JoshuaBlack0704/nerfturret/cad/Assembled Turret.png

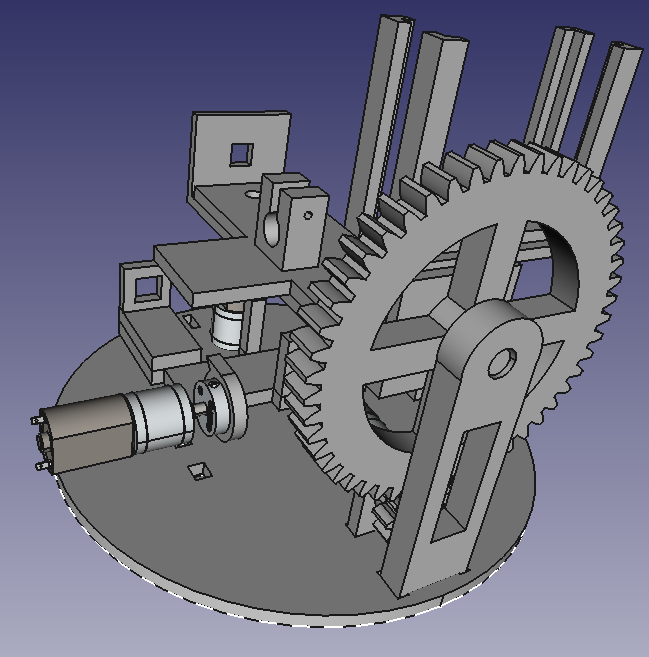
cad/Assembled Turret.png
