JoshuaBlack0704/nerfturret/cad/Base Plate Assembly.png

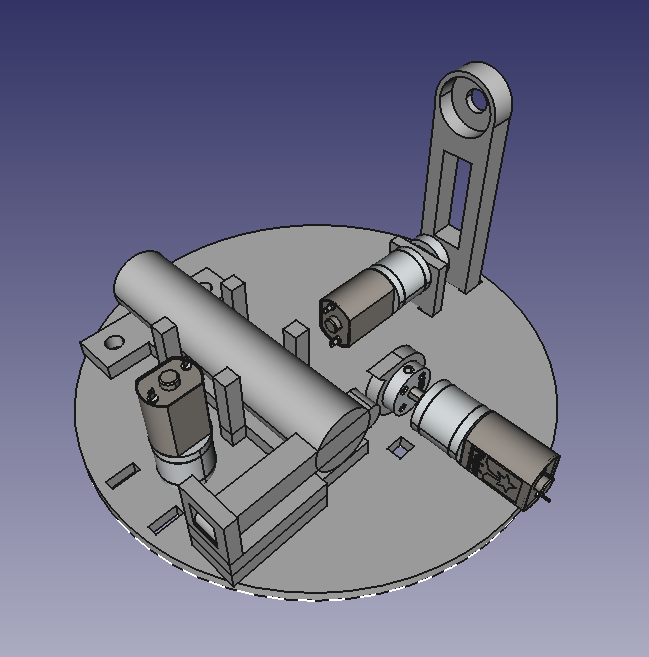
cad/Base Plate Assembly.png
