JoshuaBlack0704/nerfturret/Final Presentation Joshua Black.pdf

# Nerf Turret Project

### Produced Solo By

# Joshua Black

### Mechanical Engineering Senior

2

## Project Outline

### 1. Goals 2. Constraints 3. Mechanical Design 4. Electrical Design

### 5. Software Design

### 6. Results

0 3

## Goals

Pan-Tilt turret connectable to household network technologies 1 such as Wi-Fi.

4

Remotely controllable from any laptop. Propel Nerf darts.
Could be used to defer porch thieves.

## Constraits

- Must connect to WPA2 encrypted network. (Smart phone hot spot)
- Main structure must be 3-D printable.
- Use pressurized gas. (Potential for pepper spray)
- 5V power supply.
- Must be controlled through network clients.

2

5

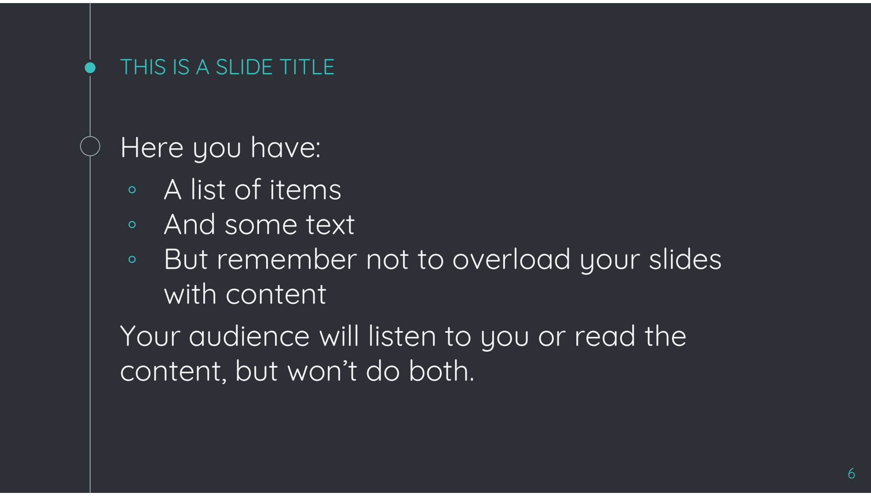
[picture p3: figure]
THIS IS A SLIDE TITLE; Here you have: ◦ A list of items ◦ And some text; with content; content, but won’t do both.

## - But remember not to overload your slides

## Your audience will listen to you or read the

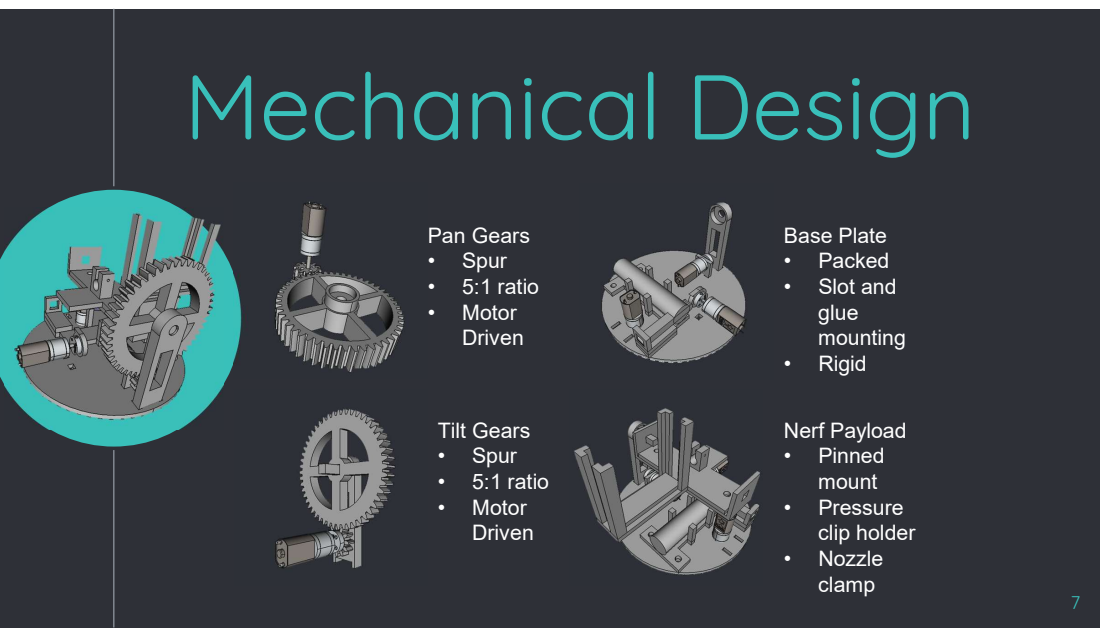
[picture p4: page 7]
Pan Gears • Spur • 5:1 ratio • Motor Driven; Tilt Gears • Spur • 5:1 ratio • Motor Driven; Base Plate • Packed • Slot and glue mounting • Rigid; Nerf Payload • Pinned mount • Pressure clip holder • Nozzle clamp

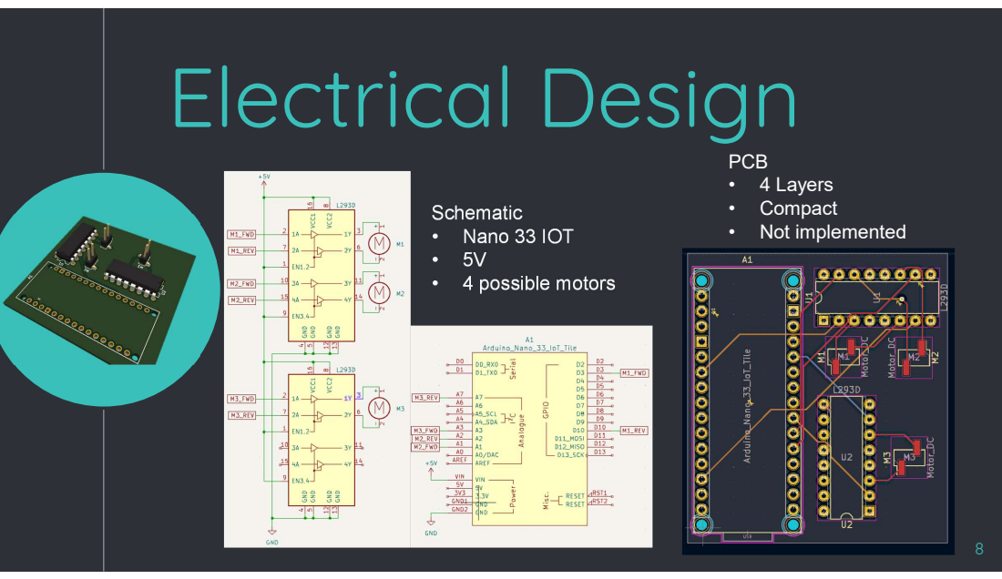
[picture p5: page 8]
Schematic • Nano 33 IOT • 5V • 4 possible motors; PCB • 4 Layers • Compact • Not implemented

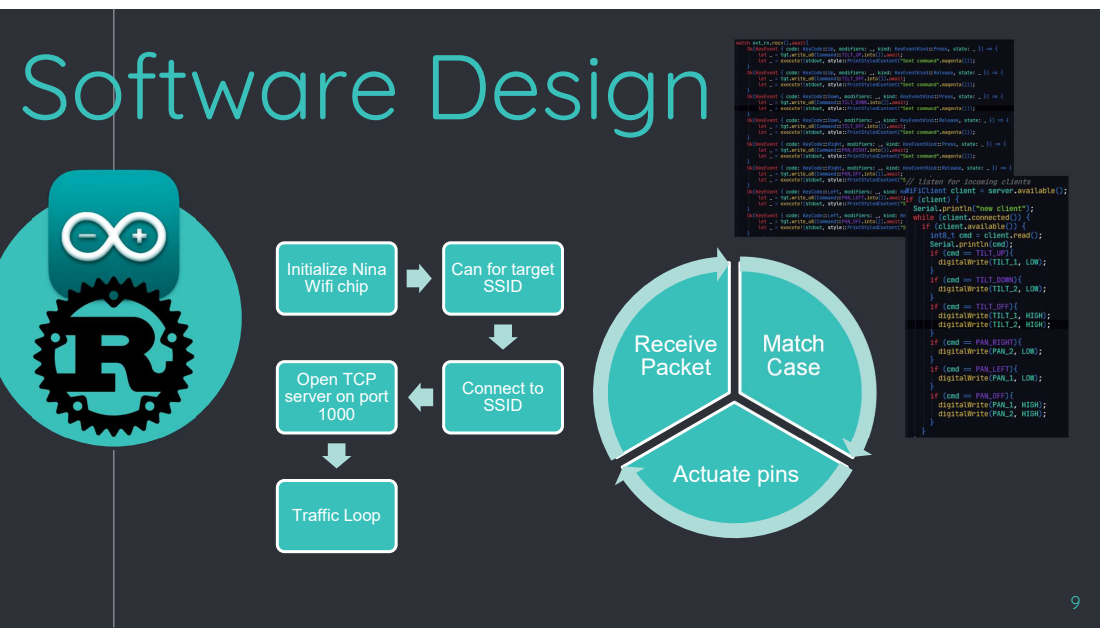
[picture p6: page 9]
Initialize Nina Wifi chip; Connect to SSID; Traffic Loop; Match Case; Actuate pins; Receive Packet

Can for target
SSID

Open TCP
server on port

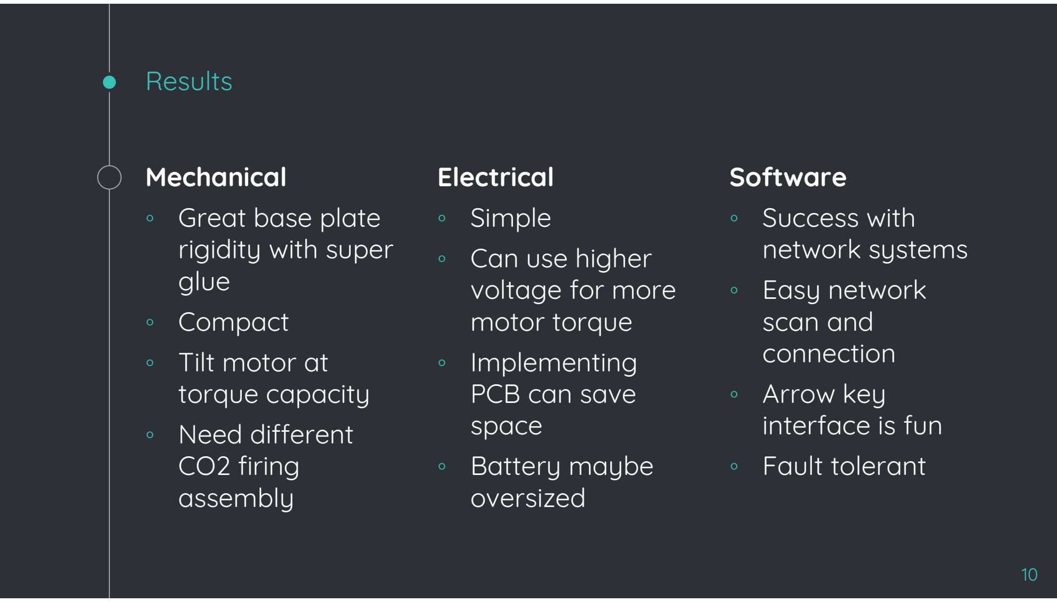
[picture p7: figure]
Results; Mechanical ◦ Great base plate rigidity with super glue ◦ Compact ◦ Tilt motor at torque capacity ◦ Need different CO2 firing assembly; Electrical ◦ Simple ◦ Can use higher voltage for more motor torque ◦ Implementing PCB can save space ◦ Battery maybe oversized; Software ◦ Success with network systems ◦ Easy network scan and connection ◦ Arrow key interface is fun ◦ Fault tolerant

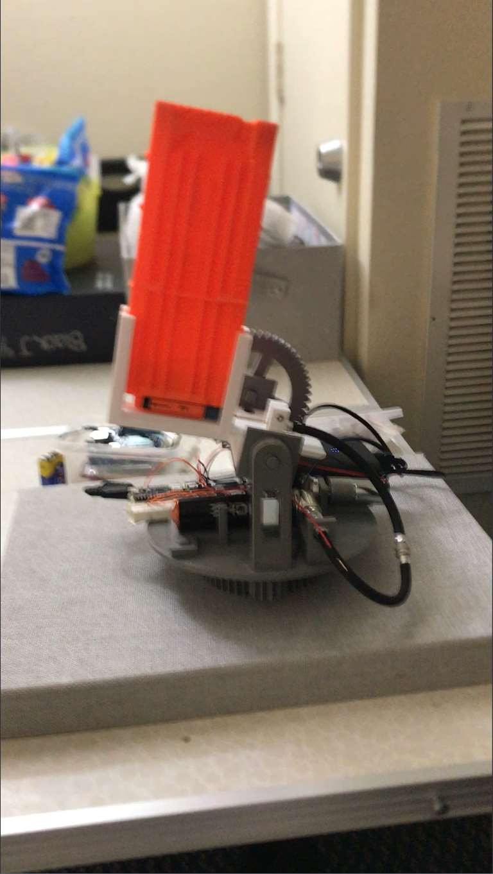
[picture p8: figure]

11

https://drive.google.co
m/file/d/11LYkKGSudl
8TtC4clvGSsLEwLnAl
pMwB/view?usp=shari
ng

Functional_turret.MOV

12
