JoshuaBlack0704/nerfturret/cad/Nerf Payload.png

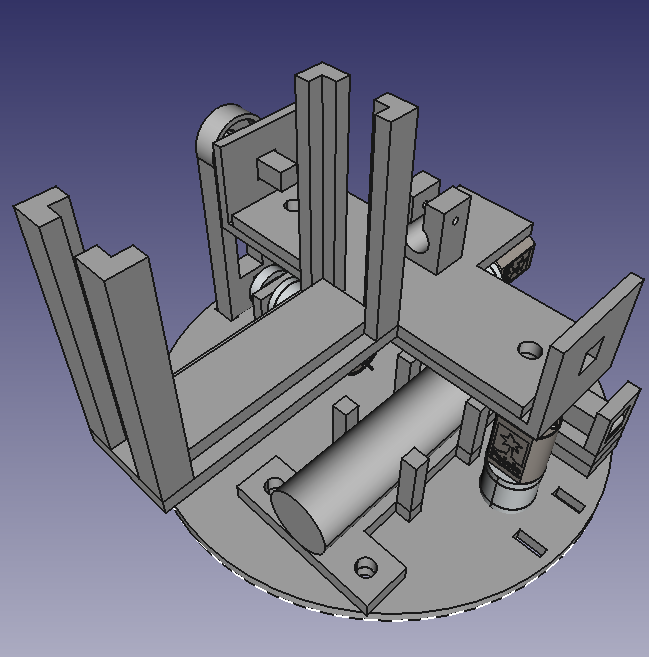
cad/Nerf Payload.png
