JoshuaBlack0704/nerfturret/cad/Pan Gear System.png

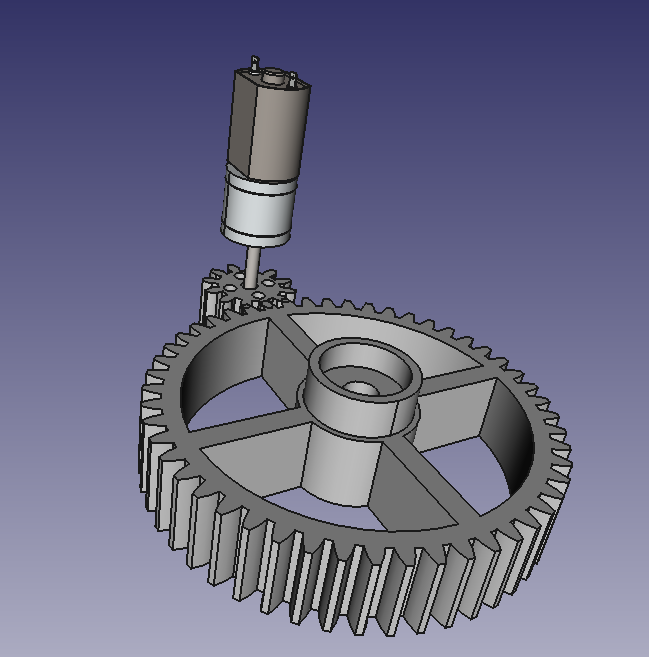
cad/Pan Gear System.png
