JoshuaBlack0704/nerfturret/cad/Tilt Gear System.png

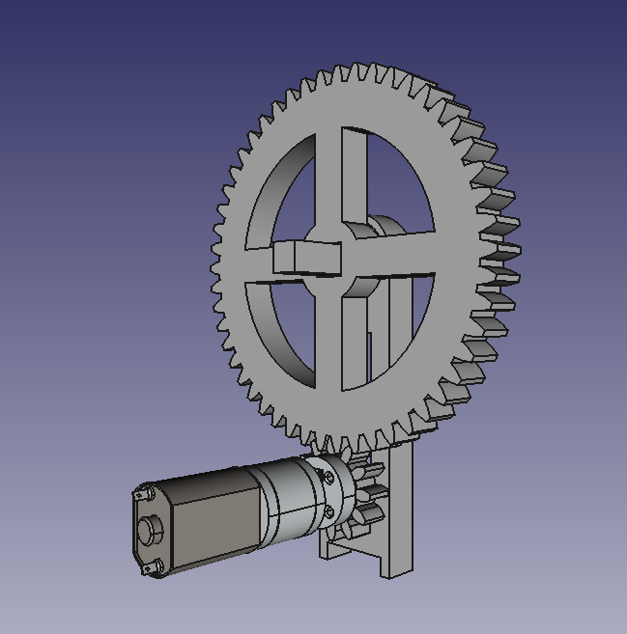
cad/Tilt Gear System.png
