JoshuaBlack0704/nerfturret/code/mcu_snippet.png

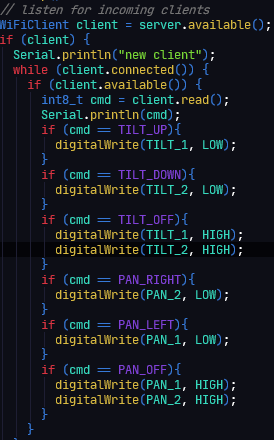
code/mcu_snippet.png
