JoshuaBlack0704/nerfturret/code/station_snippet.png

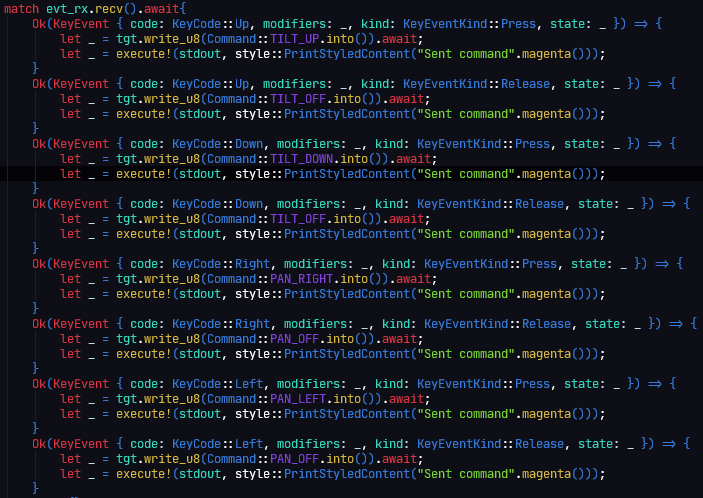
code/station_snippet.png
