JoshuaBlack0704/nerfturret/electrical/turret_control_hbridge.png

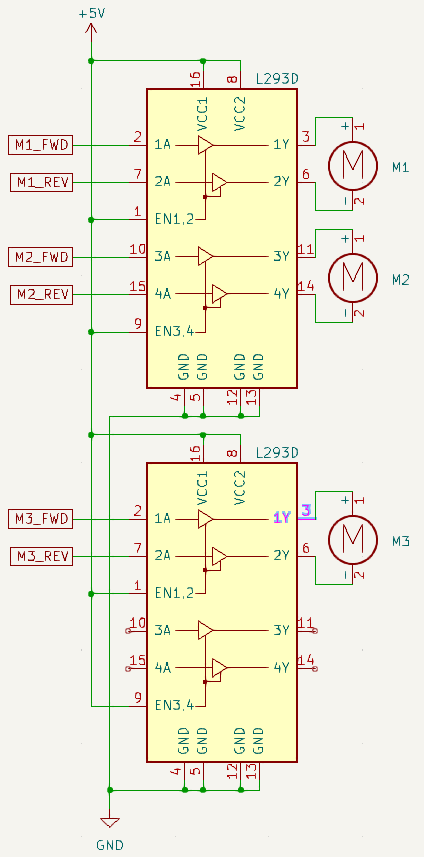
electrical/turret_control_hbridge.png
