JoshuaBlack0704/nerfturret/electrical/turret_control_nano.png

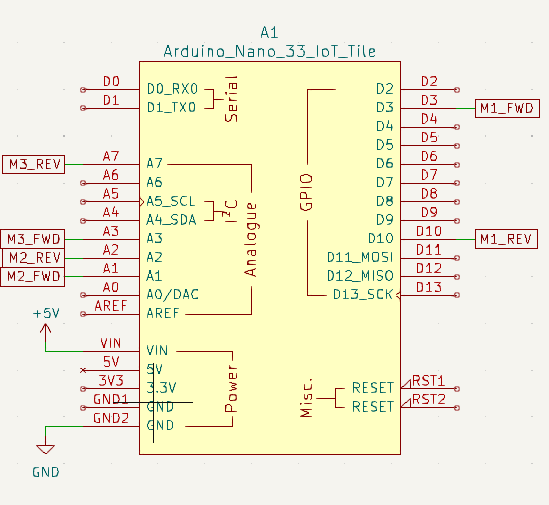
electrical/turret_control_nano.png
