JoshuaBlack0704/nerfturret/electrical/turret_control_pcb.png

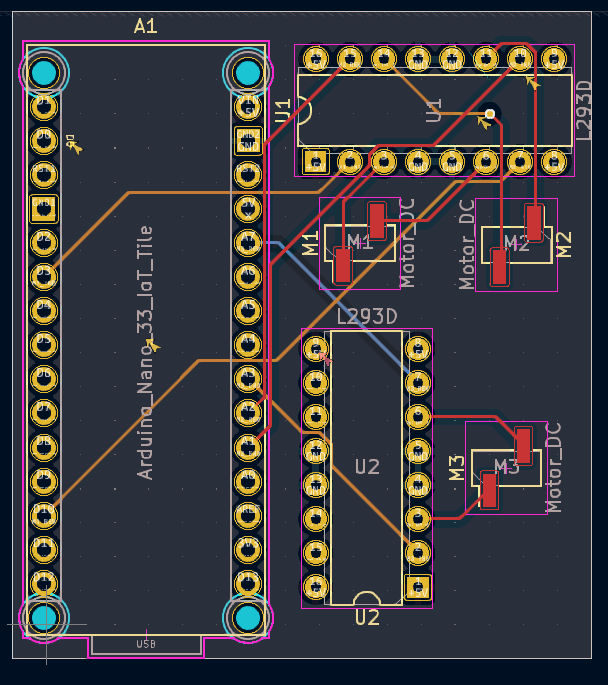
electrical/turret_control_pcb.png
