JoshuaBlack0704/nerfturret/electrical/turret_control_pcb_3d.png

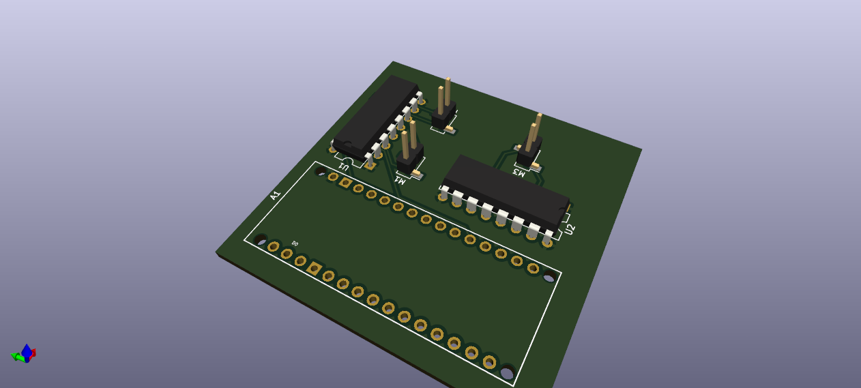
electrical/turret_control_pcb_3d.png
