JoshuaBlack0704/nerfturret/cad/turret.FCStd

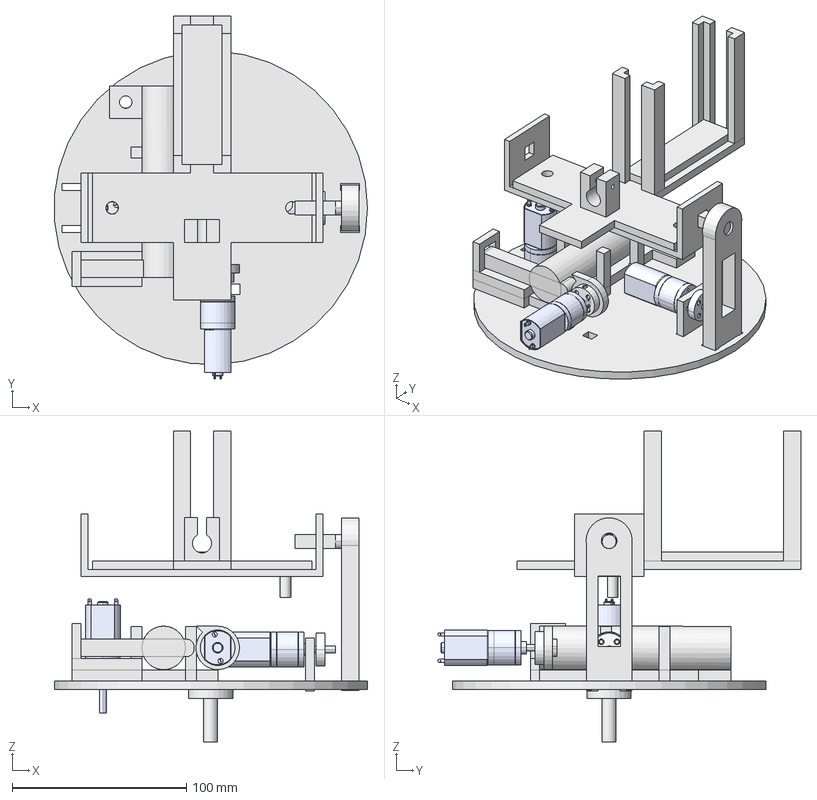
[picture p18: CAD file, 2023-05-10]
cad/turret.FCStd
179.7 x 208.1 x 178.5 mm
base_plate
motor_pin_mount
holder
tilt_pin
payload_mount
20d-metal-gearmotor-100-125-156-195
20d-metal-gearmotor-100-125-156-196
co2_holder
mount_pin
co2_push_cam
nerf_payload
pololu-universal-aluminum-mounting-hub-for-4mm-shaft-4-40-holes
pololu-universal-aluminum-mounting-hub-for-4mm-shaft-4-40-holes001
20d-metal-gearmotor-100-125-156-197
co2_
