JoshuaBlack0704/nerfturret/models/20d-metal-gearmotor-100-125-156-195.step

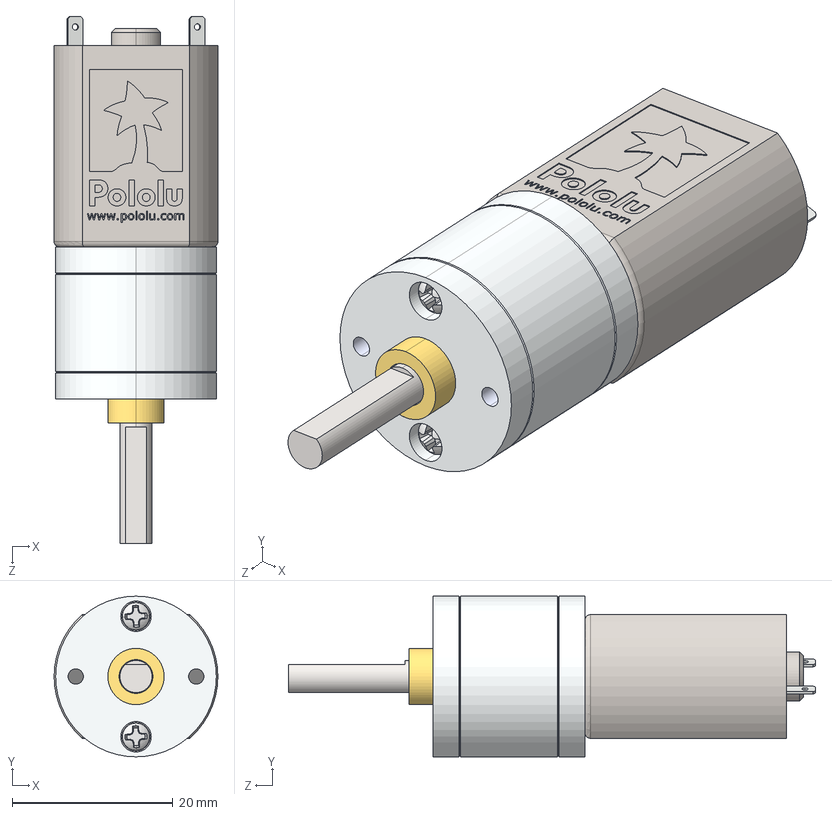
[picture p19: CAD file, 2023-03-31]
models/20d-metal-gearmotor-100-125-156-195.step
20.4 x 20.0 x 65.6 mm
