JoshuaBlack0704/nerfturret/cad/motormount.FCStd

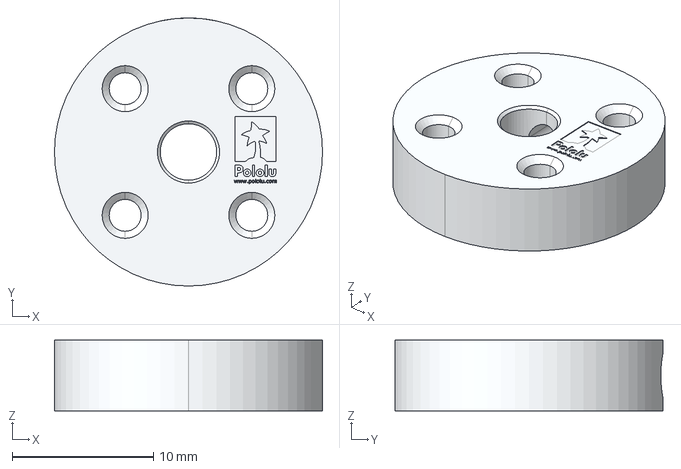
[picture p20: CAD file, 2023-03-28]
cad/motormount.FCStd
19.0 x 19.0 x 5.00 mm
