JoshuaBlack0704/nerfturret/models/20d-metal-gearmotor-250-313-391-488.step

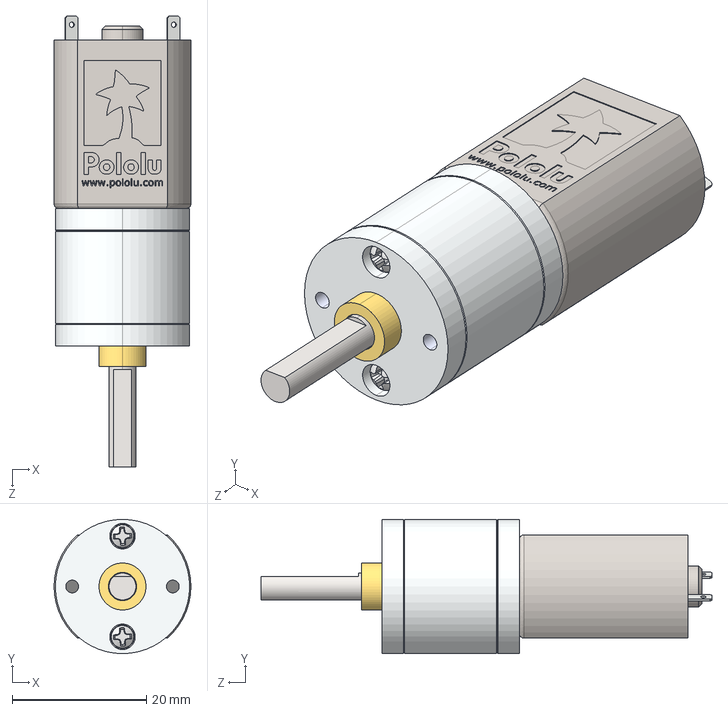
[picture p21: CAD file, 2023-03-31]
models/20d-metal-gearmotor-250-313-391-488.step
20.4 x 20.0 x 67.2 mm
