JoshuaBlack0704/nerfturret/cad/bearing.FCStd

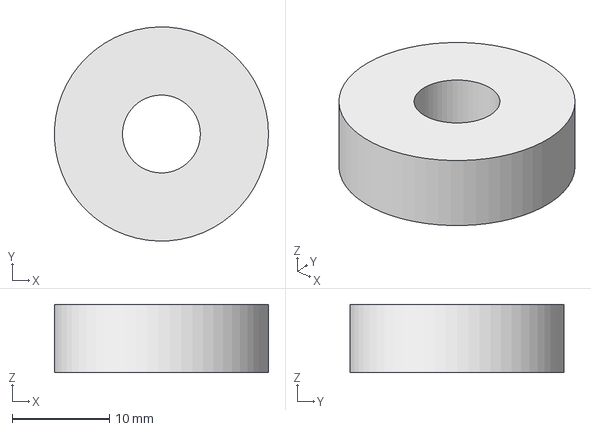
[picture p22: CAD file, 2023-03-28]
cad/bearing.FCStd
22.0 x 22.0 x 7.00 mm
