JoshuaBlack0704/nerfturret/models/20d-metal-gearmotor-100-125-156-195-with-extended-motor-shaft.step

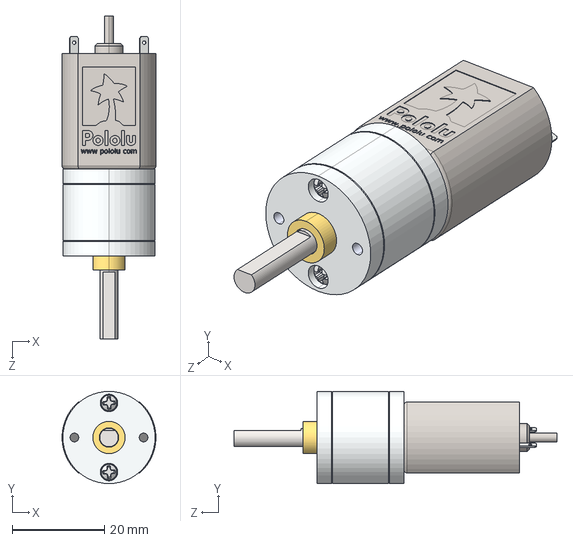
[picture p23: CAD file, 2023-03-31]
models/20d-metal-gearmotor-100-125-156-195-with-extended-motor-shaft.step
20.4 x 20.0 x 70.1 mm
