JoshuaBlack0704/nerfturret/cad/nerfdart.FCStd

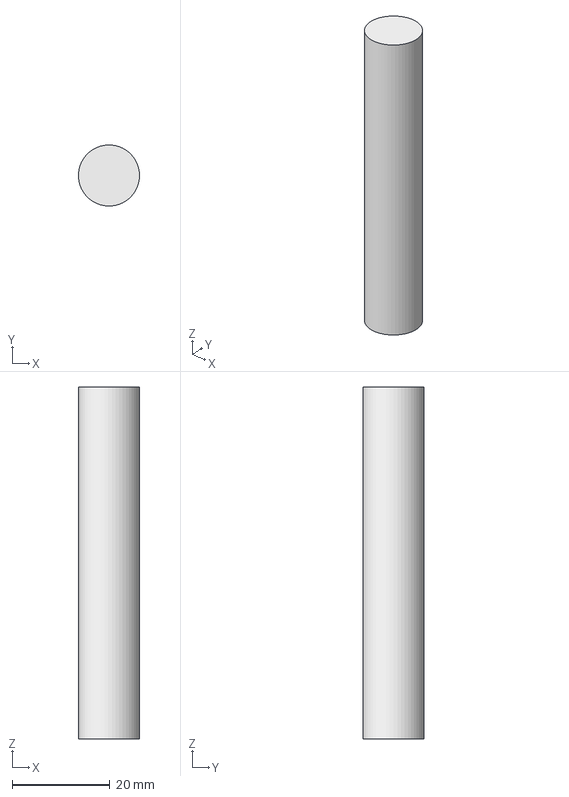
[picture p24: CAD file, 2023-03-23]
cad/nerfdart.FCStd
12.5 x 12.5 x 72.0 mm
