JoshuaBlack0704/nerfturret/cad/stl/turret-turrettilt_pin.stl

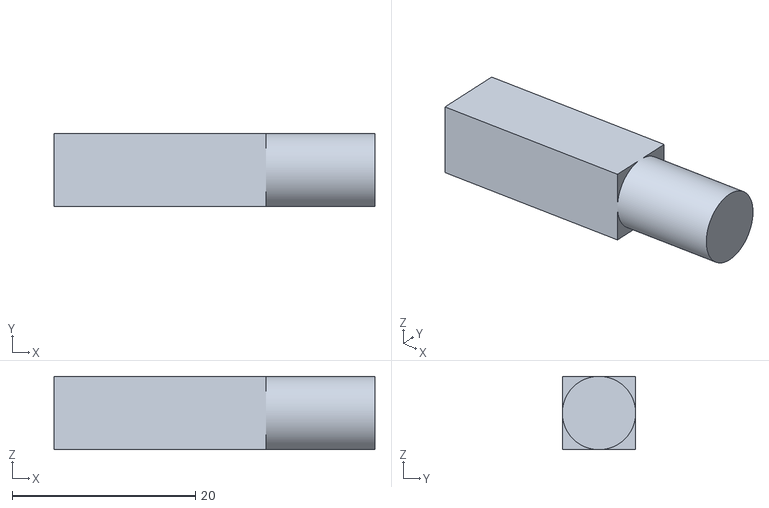
[picture p25: CAD file, 2023-05-05]
cad/stl/turret-turrettilt_pin.stl
35.0 x 8.00 x 8.00
