JoshuaBlack0704/nerfturret/models/20d-metal-gearmotor-63-78-with-extended-motor-shaft.step

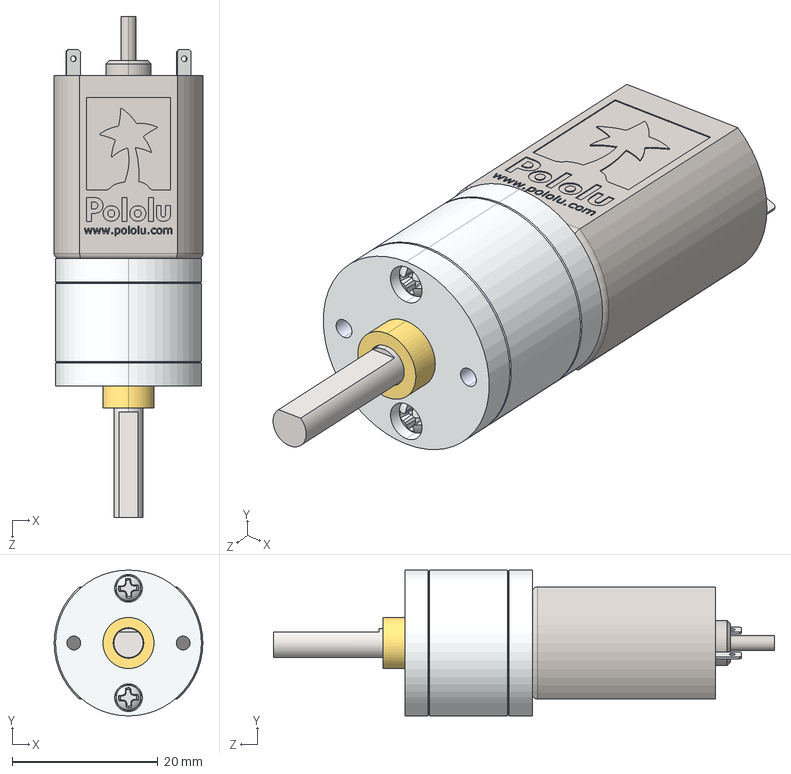
[picture p26: CAD file, 2023-03-31]
models/20d-metal-gearmotor-63-78-with-extended-motor-shaft.step
20.4 x 20.0 x 68.7 mm
