JoshuaBlack0704/nerfturret/models/20d-metal-gearmotor-63-78.step

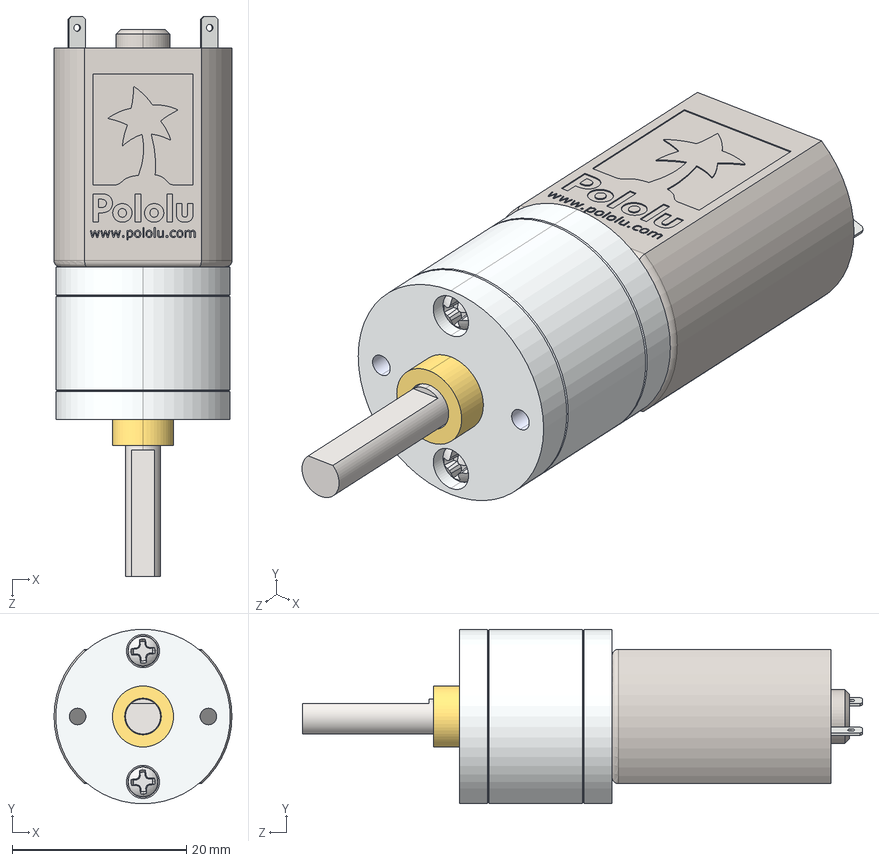
[picture p27: CAD file, 2023-03-31]
models/20d-metal-gearmotor-63-78.step
20.4 x 20.0 x 64.2 mm
