JoshuaBlack0704/nerfturret/cad/stl/turret-turretholder.stl

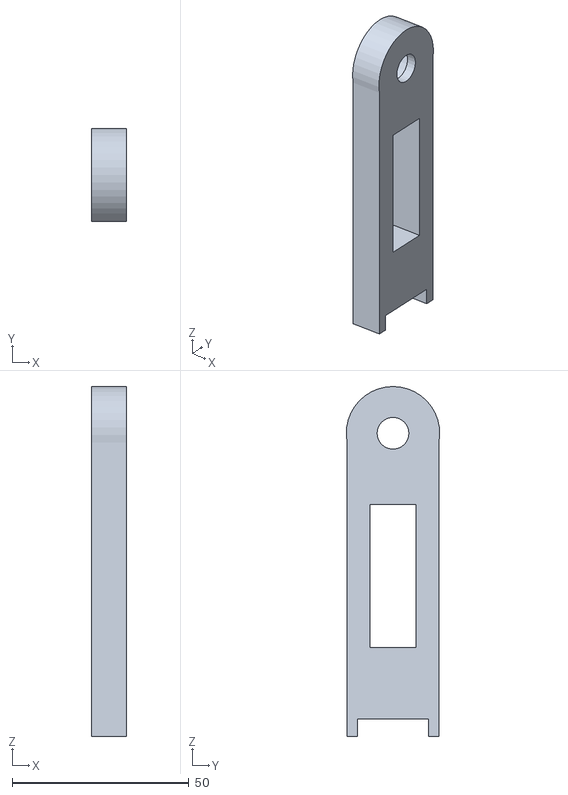
[picture p28: CAD file, 2023-05-05]
cad/stl/turret-turretholder.stl
10.0 x 26.5 x 99.1
