JoshuaBlack0704/nerfturret/models/20d-metal-gearmotor-250-313-391-488-with-extended-motor-shaft.step

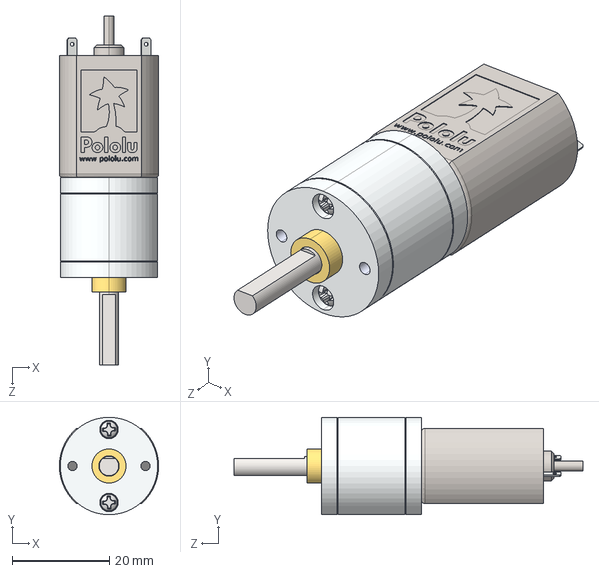
[picture p29: CAD file, 2023-03-31]
models/20d-metal-gearmotor-250-313-391-488-with-extended-motor-shaft.step
20.4 x 20.0 x 71.7 mm
