JoshuaBlack0704/nerfturret/models/20d-metal-gearmotor-25-31-with-extended-motor-shaft.step

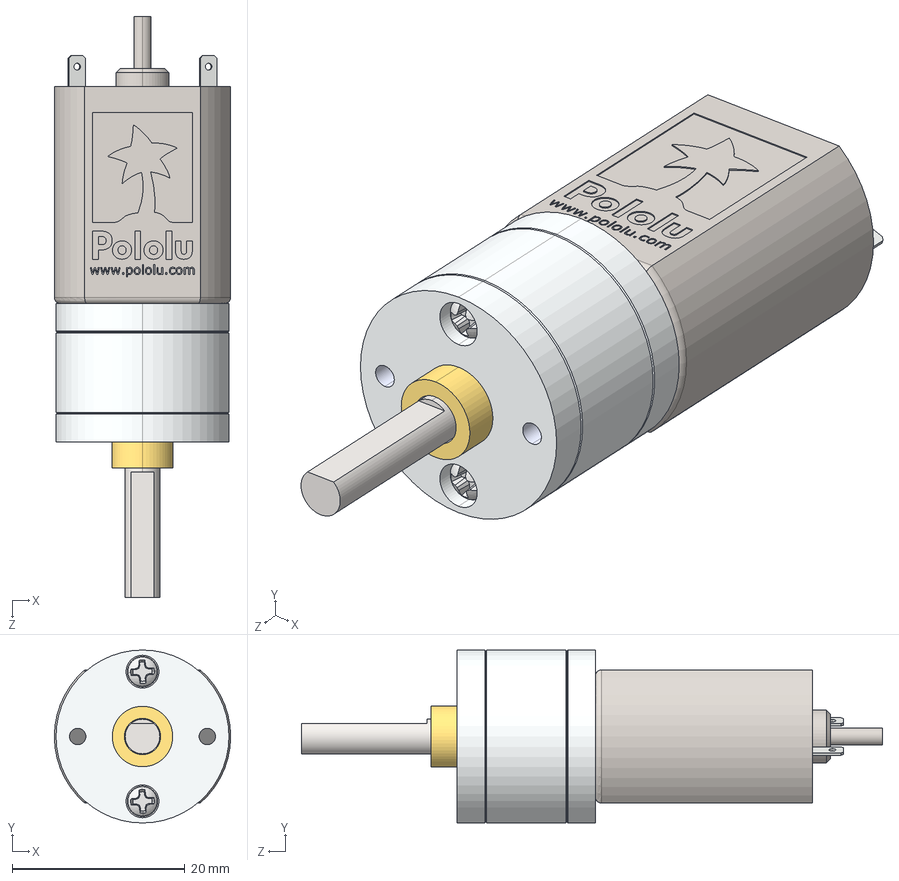
[picture p30: CAD file, 2023-03-31]
models/20d-metal-gearmotor-25-31-with-extended-motor-shaft.step
20.4 x 20.0 x 67.2 mm
