JoshuaBlack0704/nerfturret/models/20d-metal-gearmotor-25-31.step

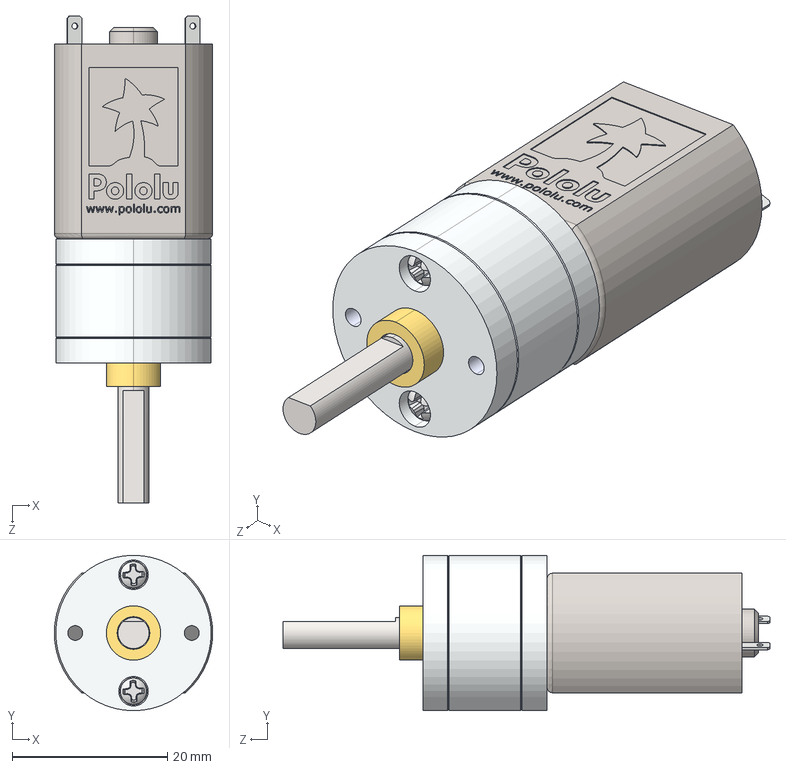
[picture p31: CAD file, 2023-03-31]
models/20d-metal-gearmotor-25-31.step
20.4 x 20.0 x 62.7 mm
