JoshuaBlack0704/nerfturret/(list of files, cad)

Other CAD files:
models/pololu-universal-aluminum-mounting-hub-for-4mm-shaft-4-40-holes.step
models/Nerf Dart.f3d
