JoshuaBlack0704/nerfturret/electrical/turret_control/turret_control.kicad_pcb

## KiCad design electrical/turret_control/turret_control.kicad_pcb (2023-05-10)

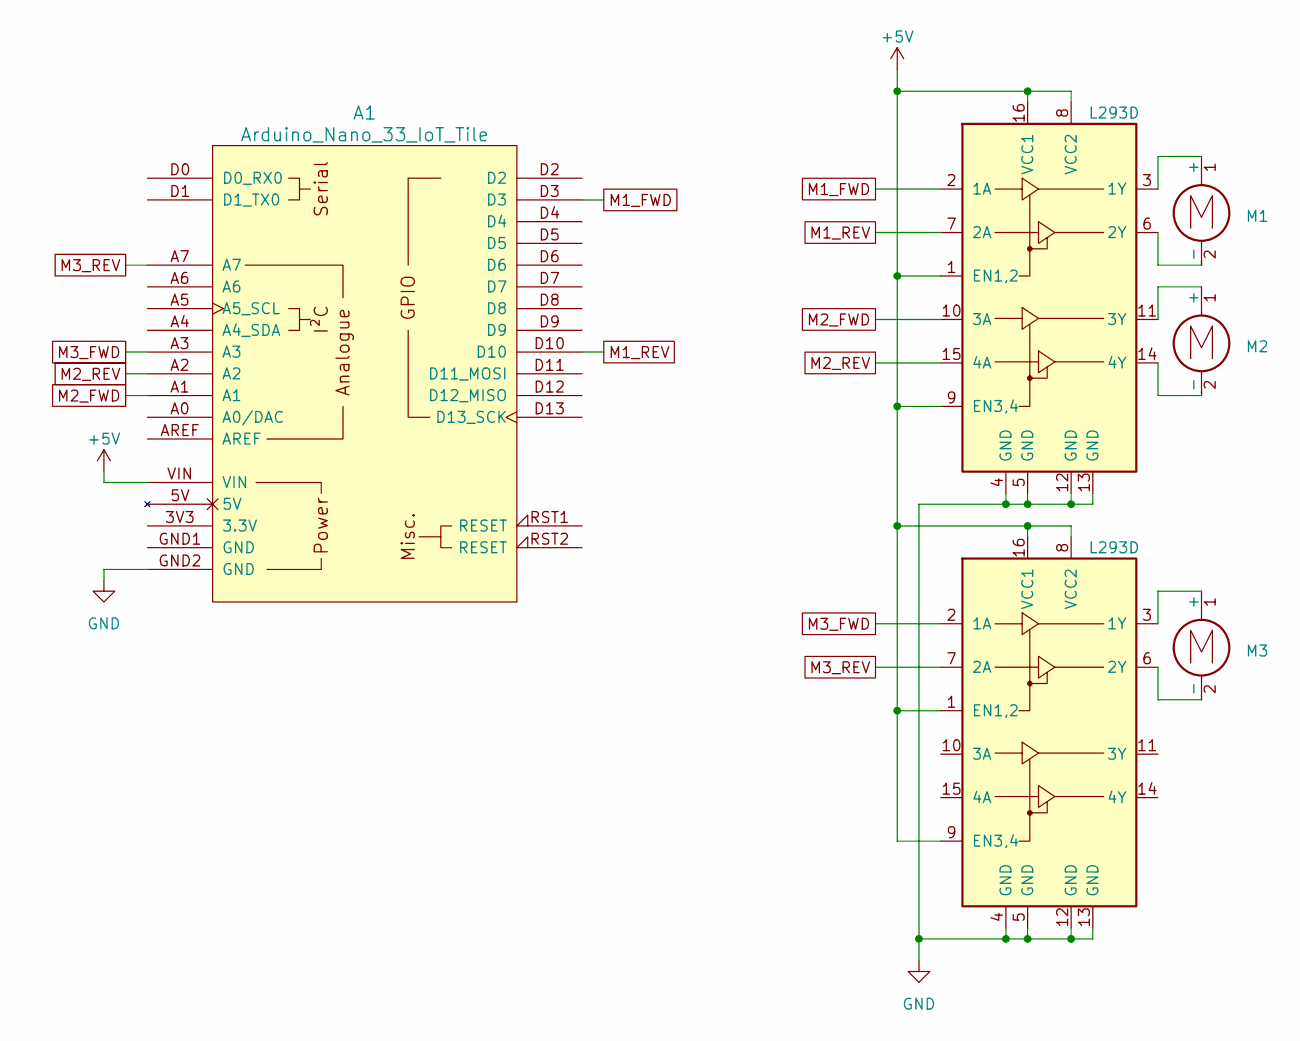
[picture p32: schematic turret_control.kicad_sch]

Parts:
A1: Arduino_Nano_33_IoT_Tile; Arduino_Nano_33_IoT_Socket
M1, M2, M3: Motor_DC; PinHeader_1x02_P2.54mm_Vertical_SMD_Pin1Left
U1, U2: L293D; DIP-16_W7.62mm

Connections:
+5V: A1.VIN, U1.1 (EN1,2), U1.8 (VCC2), U1.9 (EN3,4), U1.16 (VCC1), U2.1 (EN1,2), U2.8 (VCC2), U2.9 (EN3,4), U2.16 (VCC1)
GND: A1.GND2 (GND), U1.4 (GND), U1.5 (GND), U1.12 (GND), U1.13 (GND), U2.4 (GND), U2.5 (GND), U2.12 (GND), U2.13 (GND)
M1_FWD: A1.D3, U1.2 (1A)
M1_REV: A1.D10, U1.7 (2A)
M2_FWD: A1.A1, U1.10 (3A)
M2_REV: A1.A2, U1.15 (4A)
M3_FWD: A1.A3, U2.2 (1A)
M3_REV: A1.A7, U2.7 (2A)
unnamed: M1.1 (+), U1.3 (1Y)
unnamed: M1.2 (-), U1.6 (2Y)
unnamed: M2.1 (+), U1.11 (3Y)
unnamed: M2.2 (-), U1.14 (4Y)
unnamed: M3.1 (+), U2.3 (1Y)
unnamed: M3.2 (-), U2.6 (2Y)

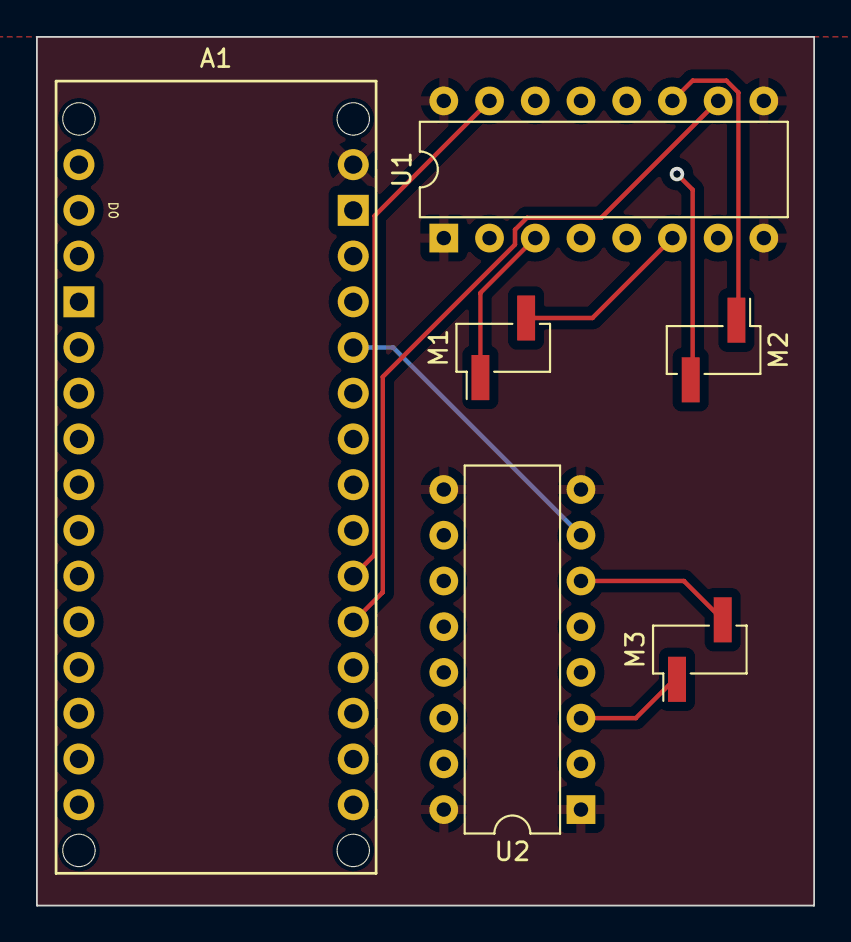
[picture p33: board turret_control.kicad_pcb from above]

Board: 4 copper layers, 43.2 x 48.3 mm, 6 parts (0 on the bottom side), 14 nets.
