JoshuaBlack0704/nerfturret/(commit log)

2023-03-23 FreeCAD practice and scaling
    [Assembly.FCStd, base.FCStd, motor.FCStd, nerfdart.FCStd]
2023-03-29 barrel cam
    [Assembly.FCStd, basegear.FCStd, co2dispenser.FCStd, motor.FCStd, turret.FCStd]
2023-03-29 motor mount
    [base-Body.stl, co2dispenser-Holder.stl, turret-barrelcam.stl, turret-motormount.stl, turret-slidelock.stl, turret-sliderail.stl, turret.FCStd]
2023-03-31 side slide design
    [20d-metal-gearmotor-100-125-156-195-with-extended-motor-shaft.step, 20d-metal-gearmotor-100-125-156-195.step, 20d-metal-gearmotor-25-31-with-extended-motor-shaft.step, 20d-metal-gearmotor-25-31.step, 20d-metal-gearmotor-250-313-391-488-with-extended-motor-shaft.step, 20d-metal-gearmotor-250-313-391-488.step, 20d-metal-gearmotor-63-78-with-extended-motor-shaft.step, 20d-metal-gearmotor-63-78.step]
2023-04-03 Clip holder v1
    [turret-norail-cam.stl, turret-norail-clipholder.stl, turret-norail-slide.stl, turret-norail.FCStd, turret-parametric-attachment.stl, turret-parametric-barrelcam.stl, turret-parametric-motormount.stl, turret-parametric-slide.stl]
2023-04-03 Slide changes
    [turret-norail.FCStd]
2023-04-10 Co2, holder
    [turret-norail.FCStd]
2023-04-16 Test assembly
    [turret-norail.FCStd]
2023-04-17 Base gear and plate
    [turret-basebase_plate.stl, turret-norail-cam.stl, turret-norail-clipholder.stl, turret-norail-slide.stl, turret-norail.FCStd, turret-parametric.FCStd, turret.FCStd]
2023-04-17 Base mounting print
    [turret-basebase_plate.stl, turret-turretbase_gear.stl, turret-turretbase_plate.stl, turret-turretmotor_pin_mount.stl, turret-turretpan_motor_gear.stl, turret.FCStd]
2023-04-18 Tilt axle holder and gear
    [turret.FCStd]
2023-04-19 Payload Mount
    [turret-turretbase_gear.stl, turret-turretbase_plate.stl, turret-turretholder.stl, turret-turretmotor_pin_mount.stl, turret-turretpan_motor_gear.stl, turret-turretpayload_mount.stl, turret-turrettilt_gear.stl, turret-turrettilt_motor_gear.stl]
2023-04-24 Co2 holder
    [turret-turretbase_gear.3mf, turret-turretbase_gear.stl, turret-turretbase_plate.3mf, turret-turretbase_plate.stl, turret-turretco2_holder.3mf, turret-turretholder.3mf, turret-turretholder.stl, turret-turretmotor_pin_mount.3mf]
2023-04-24 Mount Pin
    [turret-turretbase_gear.3mf, turret-turretbase_gear.stl, turret-turretbase_plate.3mf, turret-turretbase_plate.stl, turret-turretco2_holder.3mf, turret-turretco2_holder.stl, turret-turretholder.3mf, turret-turretholder.stl]
2023-04-26 Finished cad design
    [turret-turretbase_plate.stl, turret-turretco2_holder.stl, turret-turretco2_push_cam.stl, turret-turretholder - Copy.stl, turret-turretmotor_pin_mount - Copy.stl, turret-turretmount_pin - Copy (2).stl, turret-turretmount_pin - Copy (3).stl, turret-turretmount_pin - Copy.stl]
2023-05-05 stl upload
    [turret-turretnerf_payload.stl]
2023-05-10 Final report
    [turret.FCStd, turret_control.kicad_pcb, turret_control.kicad_sch]
